tadeguzman/IQT_FINAL_VERSION_COMMENTED/ElectronicsSchematics/README.txt

Contains:

1. PDF schematic for wiring description
2. EasyEDA Json file, which should be able to be opened in EasyEDA editor
3. Gerber File which should be able to be opened 
	3a. a revised Gerber File from OshPark since their system couldn't directly process the exported Gerber
