tadeguzman/IQT_FINAL_VERSION_COMMENTED/ElectronicsSchematics/Schematic_IQT24V23_2024-05-12.pdf

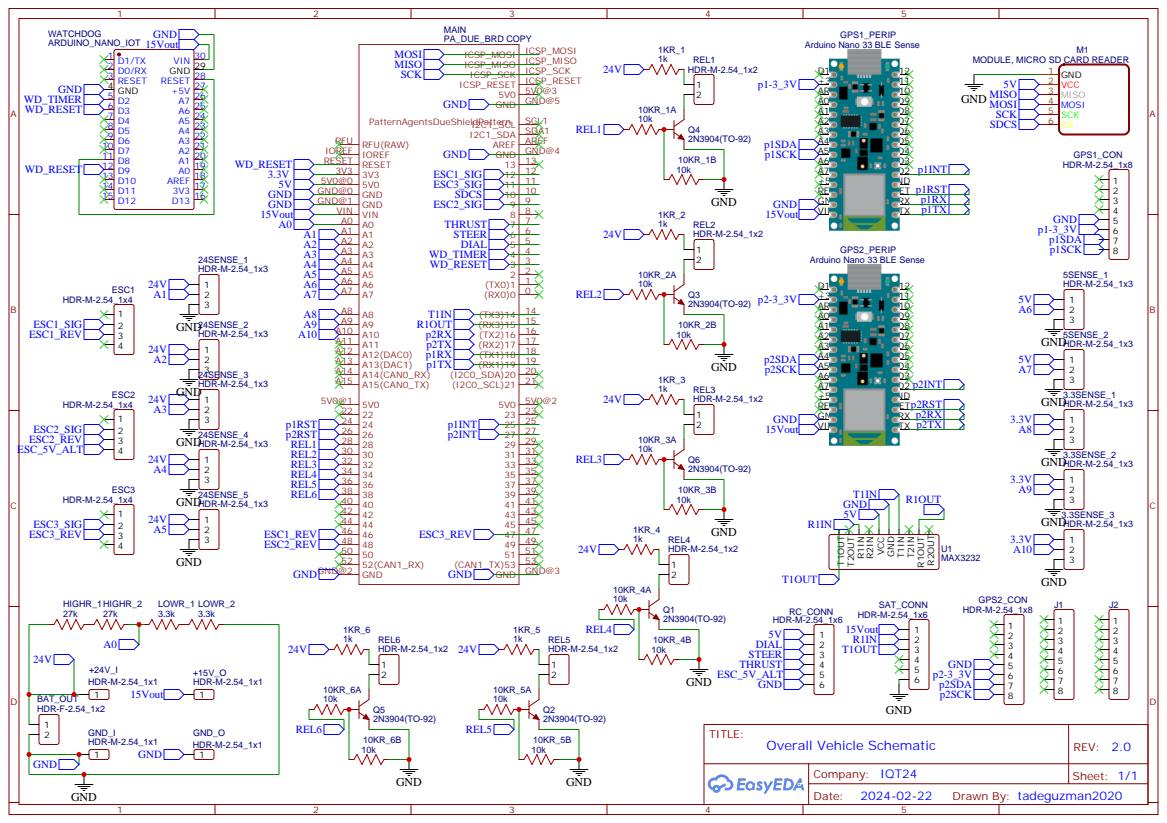
[picture p5: page 1]

MODULE, MICRO SD CARD READER

GPS2_PERIP
Arduino Nano 33 BLE Sense

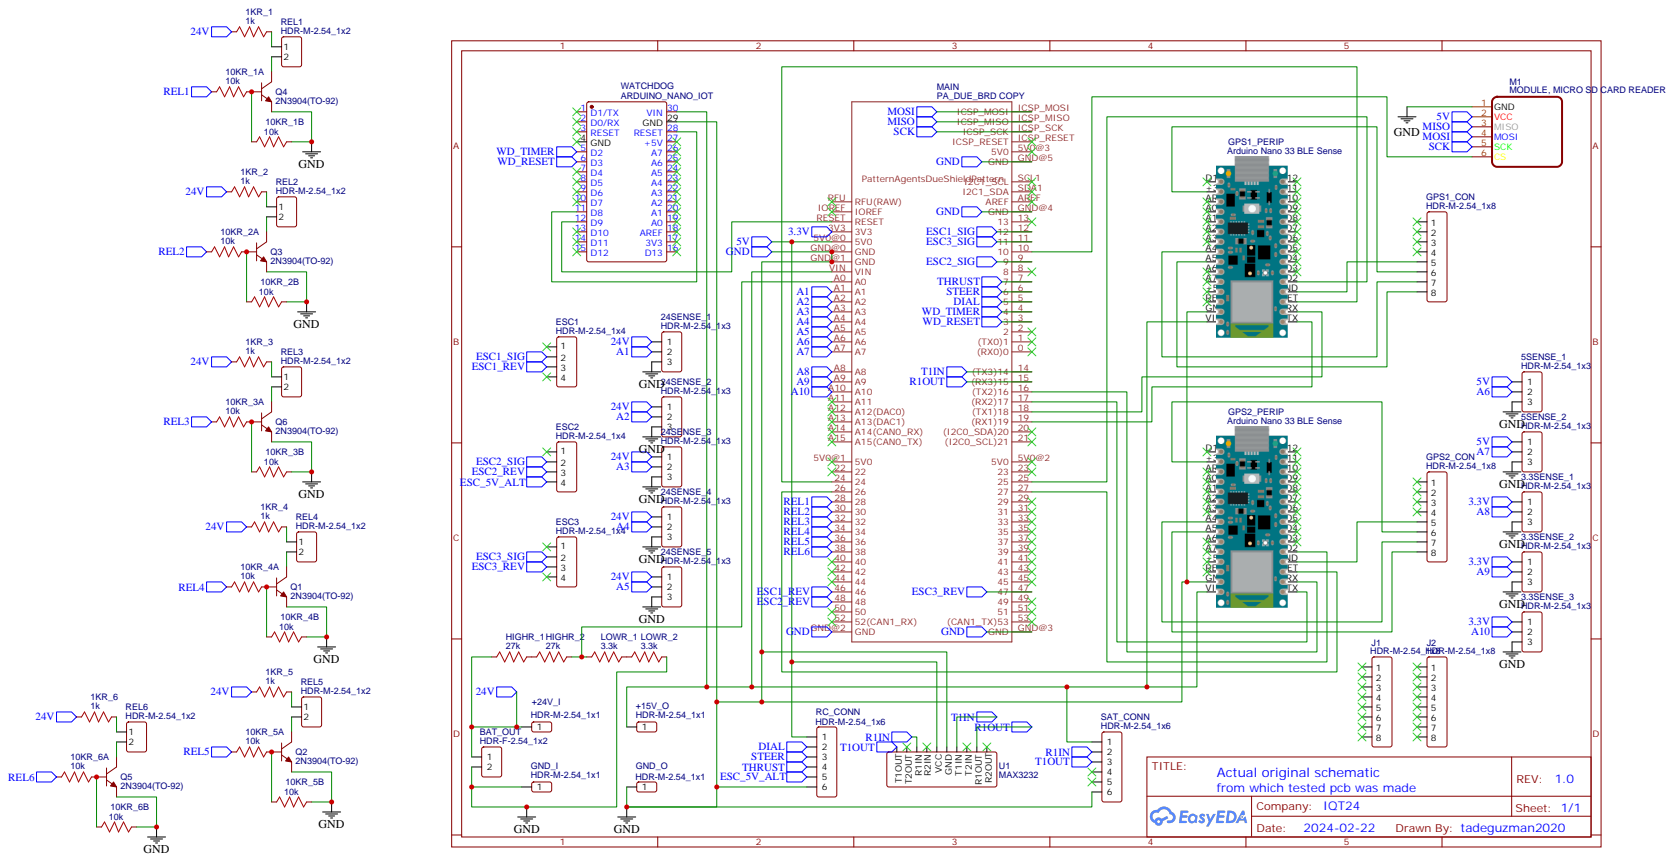
[picture p6: page 2]

GPS1_PERIP
Arduino Nano 33 BLE Sense

A11 | 17
A12(DAC0) A12 | 18
A13(DAC1) A13 | 19 20 (RX1)19
A14(CAN0_RX) A14 | 21 (I2C0_SDA)20 5V0@2 23 25

GPS2_PERIP

Actual original schematic
from which tested pcb was made
Company: IQT24
