tadeguzman/IQT_FINAL_VERSION_COMMENTED/(list of files, drawings)

Other design files:
ElectronicsSchematics/SCH_IQT24V23_2024-05-12.json
