tadeguzman/IQT_FINAL_VERSION_COMMENTED/ModifiedLibraries/Iridium_SBD/src/IridiumSBD.h

/*
IridiumSBD - An Arduino library for Iridium SBD ("Short Burst Data") Communications
Suggested and generously supported by Rock Seven Location Technology
(http://rock7mobile.com), makers of the brilliant RockBLOCK satellite modem.
Copyright (C) 2013-2017 Mikal Hart
All rights reserved.

The latest version of this library is available at http://arduiniana.org.

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
You should have received a copy of the GNU Lesser General Public
License along with this library; if not, write to the Free Software
Foundation, Inc., 51 Franklin St, Fifth Floor, Boston, MA  02110-1301  USA
*/

#include <WString.h> // for FlashString
#include <Stream.h> // for Stream
#include "Arduino.h"

#define ISBD_LIBRARY_REVISION           2
#define ISBD_DEFAULT_AT_TIMEOUT         30
#define ISBD_MSSTM_RETRY_INTERVAL       10
#define ISBD_DEFAULT_SBDIX_INTERVAL     10
#define ISBD_USB_SBDIX_INTERVAL         30
#define ISBD_DEFAULT_SENDRECEIVE_TIME   300
#define ISBD_STARTUP_MAX_TIME           240
#define ISBD_MAX_MESSAGE_LENGTH         340
#define ISBD_MSSTM_WORKAROUND_FW_VER    13001

#define ISBD_SUCCESS             0
#define ISBD_ALREADY_AWAKE       1
#define ISBD_SERIAL_FAILURE      2
#define ISBD_PROTOCOL_ERROR      3
#define ISBD_CANCELLED           4
#define ISBD_NO_MODEM_DETECTED   5
#define ISBD_SBDIX_FATAL_ERROR   6
#define ISBD_SENDRECEIVE_TIMEOUT 7
#define ISBD_RX_OVERFLOW         8
#define ISBD_REENTRANT           9
#define ISBD_IS_ASLEEP           10
#define ISBD_NO_SLEEP_PIN        11
#define ISBD_NO_NETWORK          12
#define ISBD_MSG_TOO_LONG        13

typedef const __FlashStringHelper *FlashString;

class IridiumSBD
{
public:
   int begin();
   int sendSBDText(const char *message);
   int sendSBDBinary(const uint8_t *txData, size_t txDataSize);
   int sendReceiveSBDText(const char *message, uint8_t *rxBuffer, size_t &rxBufferSize);
   int sendReceiveSBDBinary(const uint8_t *txData, size_t txDataSize, uint8_t *rxBuffer, size_t &rxBufferSize);
   int getSignalQuality(int &quality);
   int getSystemTime(struct tm &tm);
   int getFirmwareVersion(char *version, size_t bufferSize);
   int getWaitingMessageCount();
   bool isAsleep();
   bool hasRingAsserted();
   int sleep();

   typedef enum { DEFAULT_POWER_PROFILE = 0, USB_POWER_PROFILE = 1 } POWERPROFILE;
   void setPowerProfile(POWERPROFILE profile); // 0 = direct connect (default), 1 = USB
   void adjustATTimeout(int seconds);          // default value = 20 seconds
   void adjustSendReceiveTimeout(int seconds); // default value = 300 seconds
   void useMSSTMWorkaround(bool useMSSTMWorkAround); // true to use workaround from Iridium Alert 5/7/13
   void enableRingAlerts(bool enable);
   void markRingFalse();

   IridiumSBD(Stream &str, int sleepPinNo = -1, int ringPinNo = -1) :
      stream(str),
      sbdixInterval(ISBD_USB_SBDIX_INTERVAL),
      atTimeout(ISBD_DEFAULT_AT_TIMEOUT),
      sendReceiveTimeout(ISBD_DEFAULT_SENDRECEIVE_TIME),
      remainingMessages(-1),
      asleep(true),
      reentrant(false),
      sleepPin(sleepPinNo),
      ringPin(ringPinNo),
      msstmWorkaroundRequested(true),
      ringAlertsEnabled(ringPinNo != -1),
      ringAsserted(false),
      lastPowerOnTime(0UL),
      head(SBDRING),
      tail(SBDRING),
      nextChar(-1)
   {
      if (sleepPin != -1)
         pinMode(sleepPin, OUTPUT);
      if (ringPin != -1)
         pinMode(ringPin, INPUT);
   }

private:
   Stream &stream; // Communicating with the Iridium

   // Timings
   int sbdixInterval;
   int atTimeout;
   int sendReceiveTimeout;

   // State variables  
   int remainingMessages;
   bool asleep;
   bool reentrant;
   int  sleepPin;
   int  ringPin;
   bool msstmWorkaroundRequested;
   bool ringAlertsEnabled;
   bool ringAsserted;
   unsigned long lastPowerOnTime;

   // Internal utilities
   bool noBlockWait(int seconds);
   bool waitForATResponse(char *response=NULL, int responseSize=0, const char *prompt=NULL, const char *terminator="OK\r\n");

   int  internalBegin();
   int  internalSendReceiveSBD(const char *txTxtMessage, const uint8_t *txData, size_t txDataSize, uint8_t *rxBuffer, size_t *prxBufferSize);
   int  internalGetSignalQuality(int &quality);
   int  internalMSSTMWorkaround(bool &okToProceed);
   int  internalSleep();

   int  doSBDIX(uint16_t &moCode, uint16_t &moMSN, uint16_t &mtCode, uint16_t &mtMSN, uint16_t &mtLen, uint16_t &mtRemaining);
   int  doSBDRB(uint8_t *rxBuffer, size_t *prxBufferSize); // in/out
   void power(bool on);

   void send(FlashString str, bool beginLine = true, bool endLine = true);
   void send(const char *str);
   void send(uint16_t n);

   bool cancelled(); // call ISBDCallback and see if client cancelled the operation

   void diagprint(FlashString str);
   void diagprint(const char *str);
   void diagprint(uint16_t n);

   void consoleprint(FlashString str);
   void consoleprint(const char *str);
   void consoleprint(uint16_t n);
   void consoleprint(char c);
   void SBDRINGSeen();

   // Unsolicited SBDRING filter technology
   static const char SBDRING[];
   static const int FILTERTIMEOUT = 10;
   const char *head, *tail;
   int nextChar;
   void filterSBDRING();
   int filteredavailable();
   int filteredread();
};
